EV-Project/Motor-interface/README.md

# Motor-interface

## Description
This motor-interface board is used to connect motor and motor controller.

## Requirements
Power: 96V Current: 400A
Connections: PC USB 
Safety: Fuse
Survivability: IP 6/7
Size: square or retangular
