EV-Project/Motor-interface/PNG/bottom.png

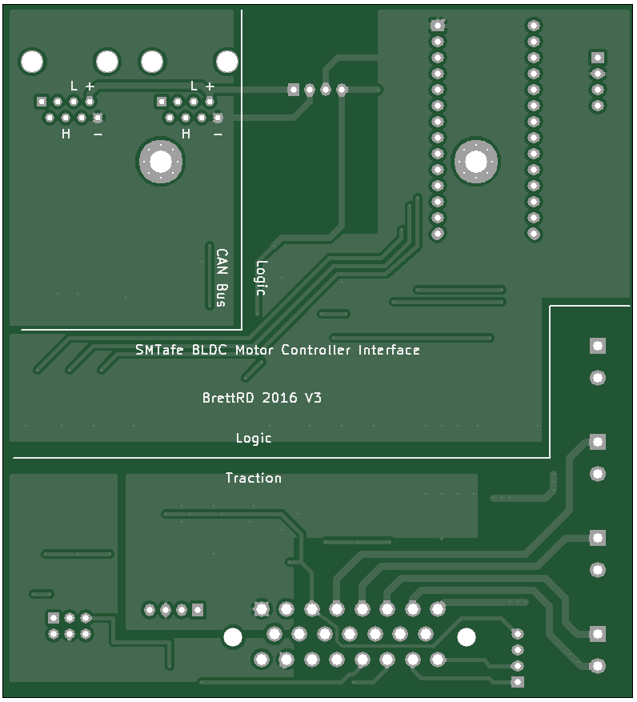
PNG/bottom.png
