EV-Project/Motor-interface/PNG/top.png

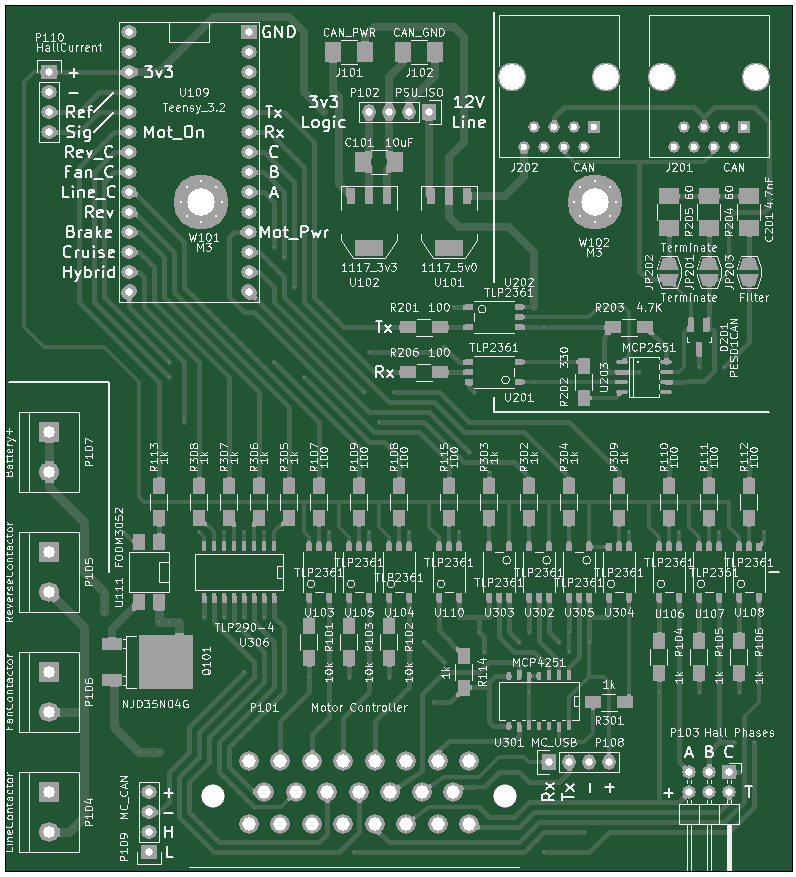
PNG/top.png
