EV-Project/Motor-interface/Motor-interface.kicad_pcb

## KiCad design Motor-interface.kicad_pcb (2016-11-17)

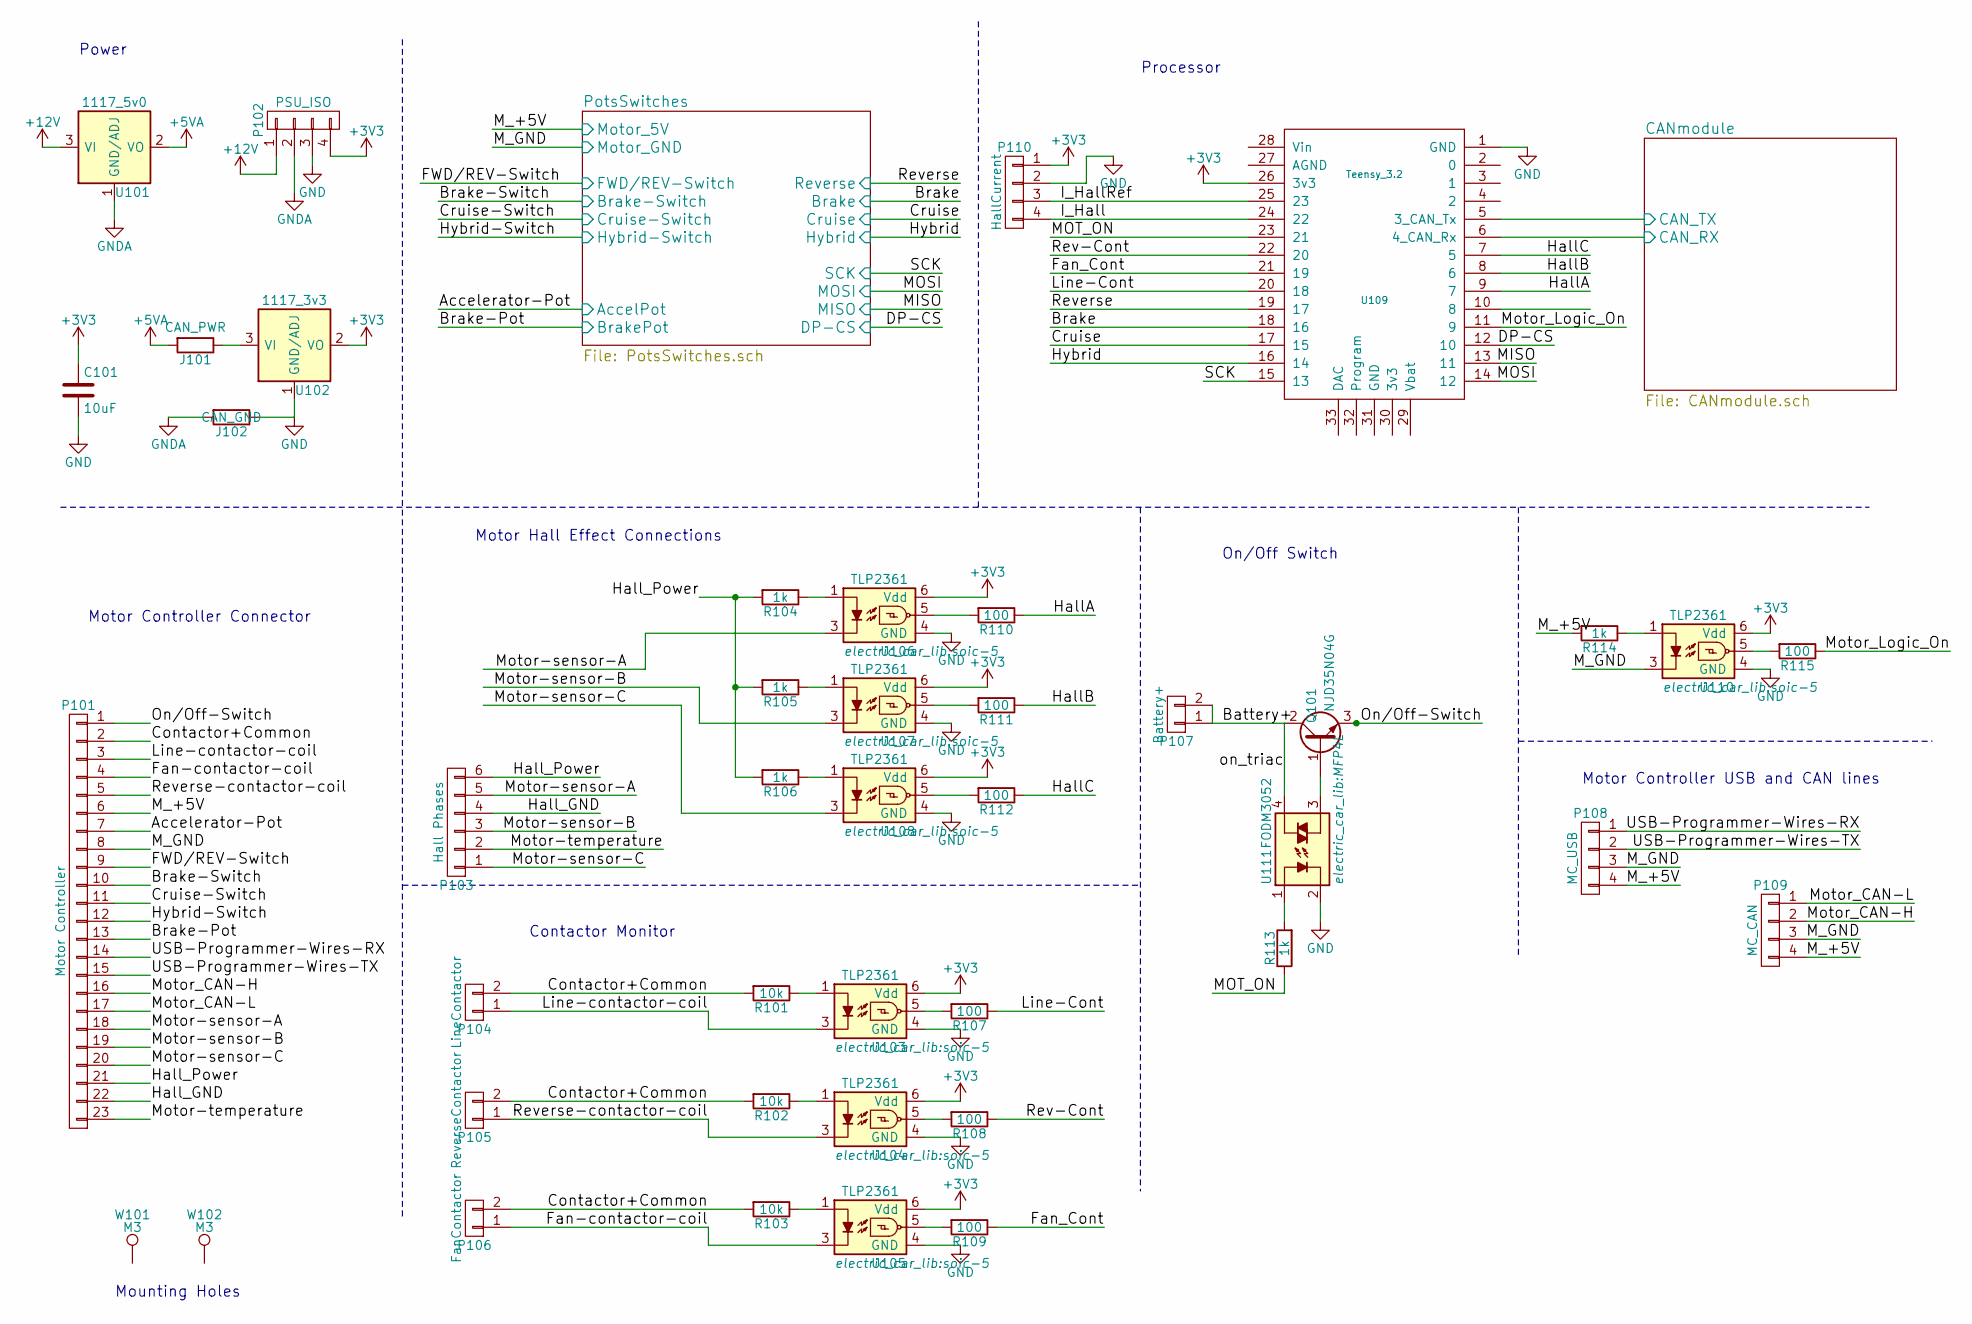
[picture p6: schematic Motor-interface.sch, Motor Interface]

Parts:
C101: 10uF; C_1210_HandSoldering
J101: CAN_PWR; R_1210_HandSoldering
J102: CAN_GND; R_1210_HandSoldering
P101: Motor Controller; TE_23_pins_776087-1_connector
P102: PSU_ISO; Pin_Header_Straight_1x04
P103: Hall Phases; Pin_Header_Angled_2x03
P104: LineContactor; bornier2
P105: ReverseContactor; bornier2
P106: FanContactor; bornier2
P107: Battery+; bornier2
P108: MC_USB; Pin_Header_Straight_1x04
P109: MC_CAN; Pin_Header_Straight_1x04
P110: HallCurrent; Pin_Header_Straight_1x04
Q101: NJD35N04G; SOT-428
R101, R102, R103: 10k; R_1206_HandSoldering
R104, R105, R106, R113, R114: 1k; R_1206_HandSoldering
R107, R108, R109, R110, R111, R112, R115: 100; R_1206_HandSoldering
U101: 1117_5v0; SOT-223
U102: 1117_3v3; SOT-223
U103, U104, U105, U106, U107, U108, U110: TLP2361; soic-5
U109: Teensy_3.2; Teensy3.2
U111: FODM3052; MFP4L
W101, W102: M3; MountingHole_3.5mm_Pad_Via

Connections:
+3V3: C101.1, P102.4, P110.1, U102.2 (VO), U103.6 (Vdd), U104.6 (Vdd), U105.6 (Vdd), U106.6 (Vdd), U107.6 (Vdd), U108.6 (Vdd), U109.26 (3v3), U110.6 (Vdd); also elsewhere on the board
+5VA: J101.2, U101.2 (VO); also elsewhere on the board
+12V: P102.1, U101.3 (VI); also elsewhere on the board
/Accelerator-Pot: P101.7; also elsewhere on the board
/Battery+: P107.1, P107.2, Q101.2 (C), U111.4
/Brake: U109.18 (16); also elsewhere on the board
/Brake-Pot: P101.13; also elsewhere on the board
/Brake-Switch: P101.10; also elsewhere on the board
/CANmodule/CAN_RX: U109.6 (4_CAN_Rx); also elsewhere on the board
/CANmodule/CAN_TX: U109.5 (3_CAN_Tx); also elsewhere on the board
/Contactor+Common: P101.2, P104.2, P105.2, P106.2, R101.2, R102.2, R103.2
/Cruise: U109.17 (15); also elsewhere on the board
/Cruise-Switch: P101.11; also elsewhere on the board
/DP-CS: U109.12 (10); also elsewhere on the board
/FWD/REV-Switch: P101.9; also elsewhere on the board
/Fan-contactor-coil: P101.4, P106.1, U105.3
/Fan_Cont: R109.1, U109.21 (19)
/HallA: R110.1, U109.9 (7)
/HallB: R111.1, U109.8 (6)
/HallC: R112.1, U109.7 (5)
/Hall_GND: P101.22, P103.4
/Hall_Power: P101.21, P103.6, R104.2, R105.2, R106.2
/Hybrid: U109.16 (14); also elsewhere on the board
/Hybrid-Switch: P101.12; also elsewhere on the board
/I_Hall: P110.4, U109.24 (22)
/I_HallRef: P110.3, U109.25 (23)
/Line-Cont: R107.1, U109.20 (18)
/Line-contactor-coil: P101.3, P104.1, U103.3
/MISO: U109.13 (11); also elsewhere on the board
/MOSI: U109.14 (12); also elsewhere on the board
/MOT_ON: R113.1, U109.23 (21)
/M_+5V: P101.6, P108.4, P109.4, R114.2; also elsewhere on the board
/M_GND: P101.8, P108.3, P109.3, U110.3; also elsewhere on the board
/Motor-sensor-A: P101.18, P103.5, U106.3
/Motor-sensor-B: P101.19, P103.3, U107.3
/Motor-sensor-C: P101.20, P103.1, U108.3
/Motor-temperature: P101.23, P103.2
/Motor_CAN-H: P101.16, P109.2
/Motor_CAN-L: P101.17, P109.1
/Motor_Logic_On: R115.1, U109.11 (9)
/On/Off-Switch: P101.1, Q101.3 (E)
/Rev-Cont: R108.1, U109.22 (20)
/Reverse: U109.19 (17); also elsewhere on the board
/Reverse-contactor-coil: P101.5, P105.1, U104.3
/SCK: U109.15 (13); also elsewhere on the board
/USB-Programmer-Wires-RX: P101.14, P108.1
/USB-Programmer-Wires-TX: P101.15, P108.2
GND: C101.2, J102.1, P102.3, P110.2, U102.1 (GND/ADJ), U103.4 (GND), U104.4 (GND), U105.4 (GND), U106.4 (GND), U107.4 (GND), U108.4 (GND), U109.1 (GND), U110.4 (GND), U111.2; also elsewhere on the board
GNDA: J102.2, P102.2, U101.1 (GND/ADJ); also elsewhere on the board
unnamed: J101.1, U102.3 (VI)
unnamed: Q101.1 (B), U111.3
unnamed: R101.1, U103.1
unnamed: R102.1, U104.1
unnamed: R103.1, U105.1
unnamed: R104.1, U106.1
unnamed: R105.1, U107.1
unnamed: R106.1, U108.1
unnamed: R107.2, U103.5
unnamed: R108.2, U104.5
unnamed: R109.2, U105.5
unnamed: R110.2, U106.5
unnamed: R111.2, U107.5
unnamed: R112.2, U108.5
unnamed: R113.2, U111.1
unnamed: R114.1, U110.1
unnamed: R115.2, U110.5

Notes on the sheet:
On/Off Switch
Contactor Monitor
Processor
Motor Hall Effect Connections
Motor Controller USB and CAN lines
Power
Motor Controller Connector
Mounting Holes

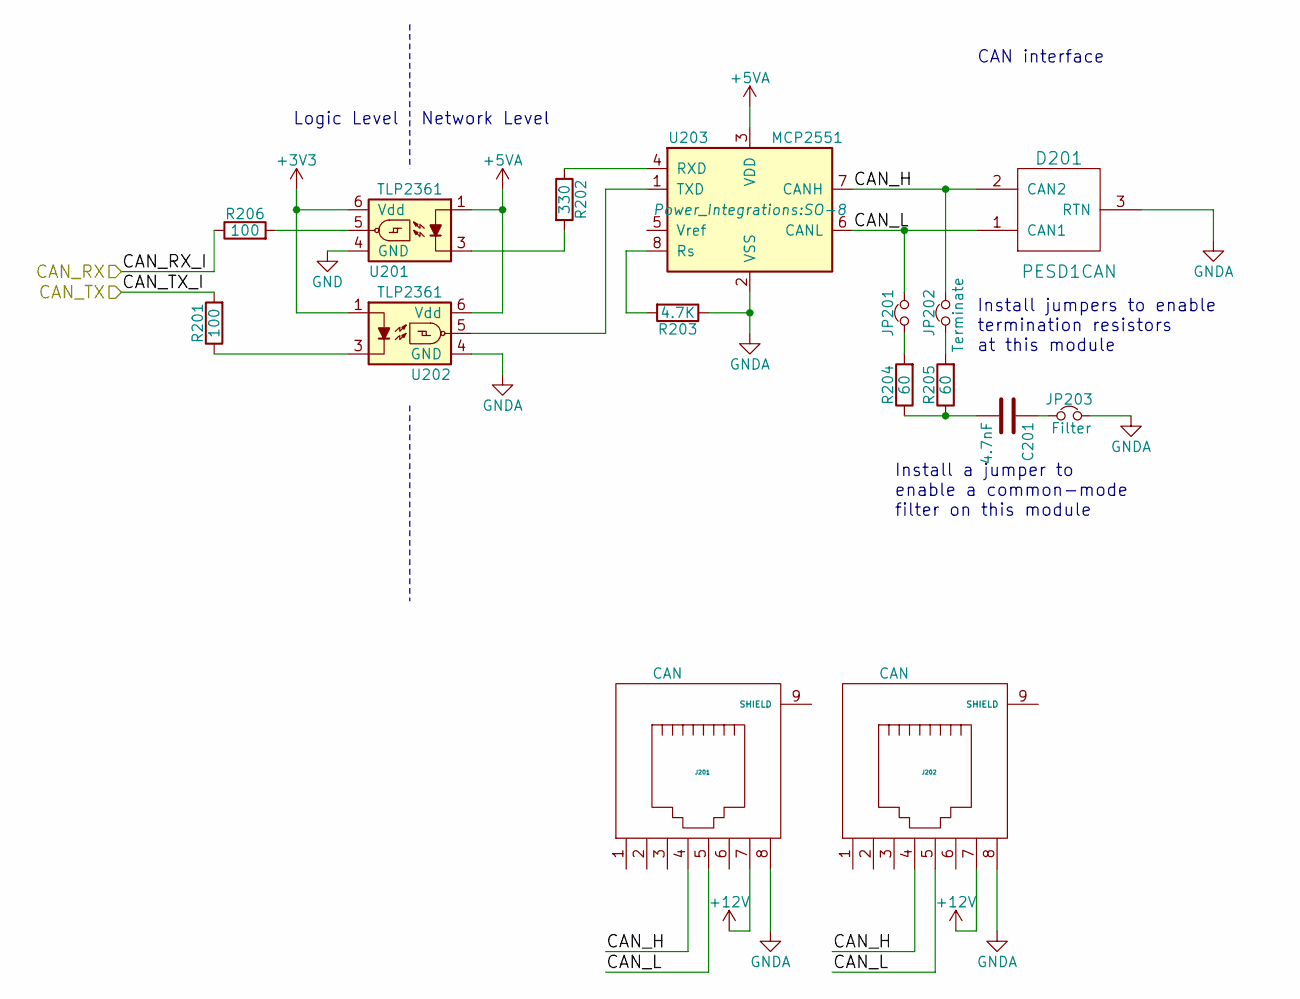
[picture p7: schematic CANmodule.sch, CAN adapter]

Parts:
C201: 4.7nF; C_1210_HandSoldering
D201: PESD1CAN; SOT-23_Handsoldering
J201, J202: CAN; RJ45_8
JP201, JP202: Terminate; JumperSingle
JP203: Filter; JumperSingle
R201, R206: 100; R_1206_HandSoldering
R202: 330; R_1206_HandSoldering
R203: 4.7K; R_1206_HandSoldering
R204, R205: 60; R_1210_HandSoldering
U201, U202: TLP2361; soic-5
U203: MCP2551; SO-8

Connections:
+3V3: U201.6 (Vdd), U202.1; also elsewhere on the board
+5VA: U201.1, U202.6 (Vdd), U203.3 (VDD); also elsewhere on the board
+12V: J201.7, J202.7; also elsewhere on the board
/CANmodule/CAN_H: D201.2 (CAN2), J201.4, J202.4, JP202.1, U203.7 (CANH)
/CANmodule/CAN_L: D201.1 (CAN1), J201.5, J202.5, JP201.2, U203.6 (CANL)
/CANmodule/CAN_RX: R206.1; also elsewhere on the board
/CANmodule/CAN_TX: R201.2; also elsewhere on the board
GND: U201.4 (GND); also elsewhere on the board
GNDA: D201.3 (RTN), J201.8, J202.8, JP203.2, R203.1, U202.4 (GND), U203.2 (VSS); also elsewhere on the board
unnamed: C201.1, JP203.1
unnamed: C201.2, R204.1, R205.1
unnamed: JP201.1, R204.2
unnamed: JP202.2, R205.2
unnamed: R201.1, U202.3
unnamed: R202.1, U203.4 (RXD)
unnamed: R202.2, U201.3
unnamed: R203.2, U203.8 (Rs)
unnamed: R206.2, U201.5
unnamed: U202.5, U203.1 (TXD)

Notes on the sheet:
Logic Level
Network Level
Install jumpers to enable termination resistors at this module
Install a jumper to enable a common-mode filter on this module
CAN interface

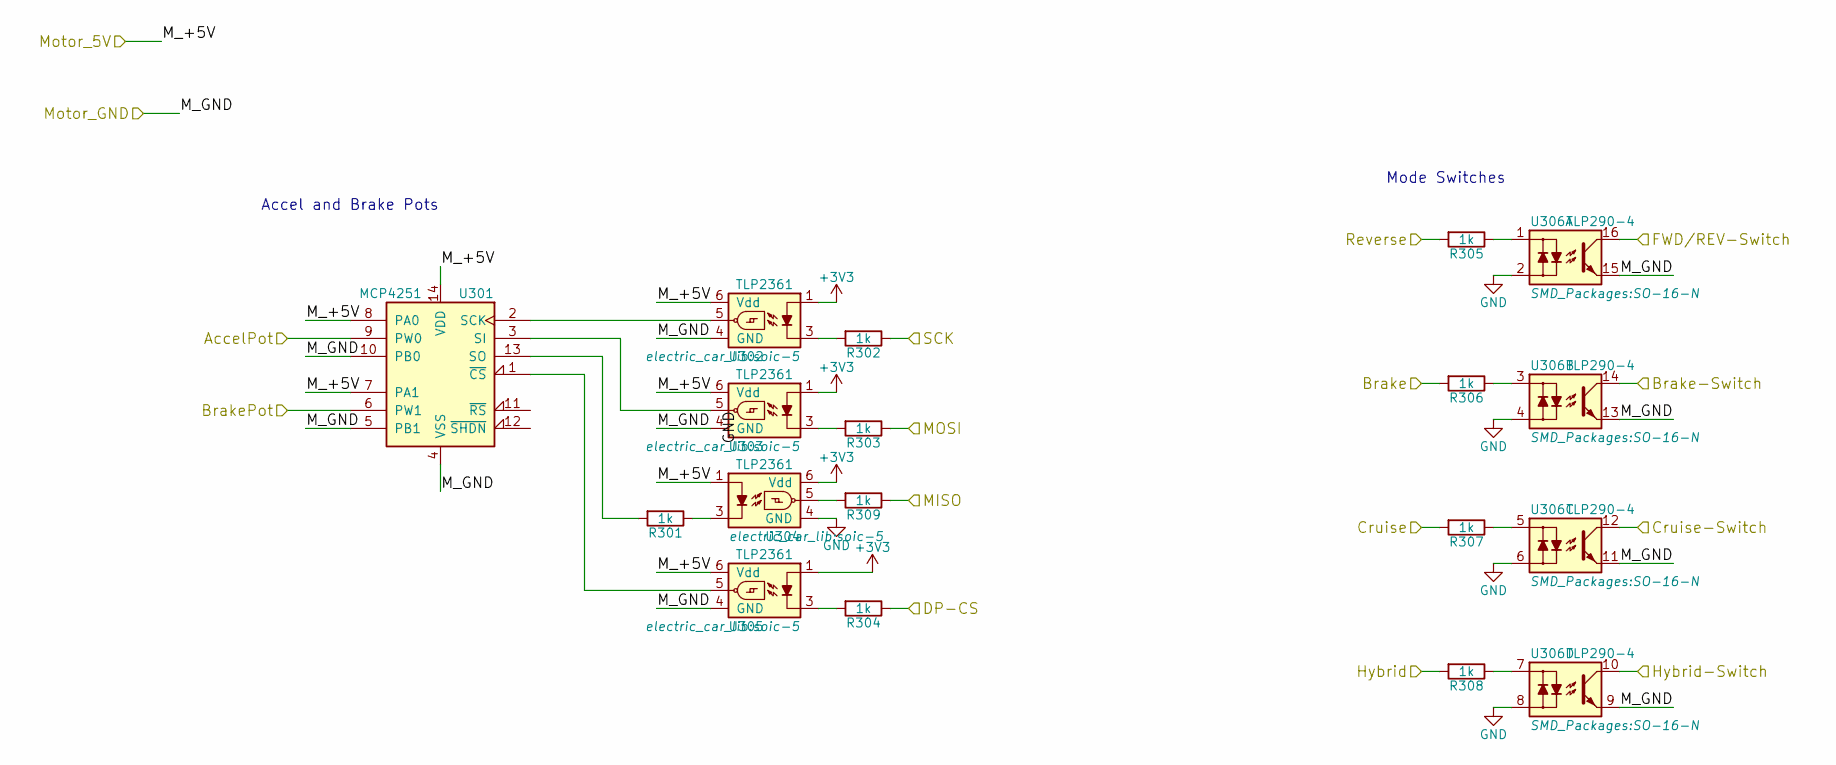
[picture p8: schematic PotsSwitches.sch, Motor Interface]

Parts:
R301, R302, R303, R304, R305, R306, R307, R308, R309: 1k; R_1206_HandSoldering
U301: MCP4251; SOIC-14_N
U302, U303, U304, U305: TLP2361; soic-5
U306: TLP290-4; SO-16-N

Connections:
+3V3: U302.1, U303.1, U304.6 (Vdd), U305.1; also elsewhere on the board
/Accelerator-Pot: U301.9 (PW0); also elsewhere on the board
/Brake: R306.2; also elsewhere on the board
/Brake-Pot: U301.6 (PW1); also elsewhere on the board
/Brake-Switch: U306.14; also elsewhere on the board
/Cruise: R307.2; also elsewhere on the board
/Cruise-Switch: U306.12; also elsewhere on the board
/DP-CS: R304.1; also elsewhere on the board
/FWD/REV-Switch: U306.16; also elsewhere on the board
/Hybrid: R308.2; also elsewhere on the board
/Hybrid-Switch: U306.10; also elsewhere on the board
/MISO: R309.1; also elsewhere on the board
/MOSI: R303.1; also elsewhere on the board
/M_+5V: U301.7 (PA1), U301.8 (PA0), U301.14 (VDD), U302.6 (Vdd), U303.6 (Vdd), U304.1, U305.6 (Vdd); also elsewhere on the board
/M_GND: U301.4 (VSS), U301.5 (PB1), U301.10 (PB0), U302.4 (GND), U303.4 (GND), U305.4 (GND), U306.9, U306.11, U306.13, U306.15; also elsewhere on the board
/Reverse: R305.2; also elsewhere on the board
/SCK: R302.1; also elsewhere on the board
GND: U304.4 (GND), U306.2, U306.4, U306.6, U306.8; also elsewhere on the board
unnamed: R301.1, U304.3
unnamed: R301.2, U301.13 (SO)
unnamed: R302.2, U302.3
unnamed: R303.2, U303.3
unnamed: R304.2, U305.3
unnamed: R305.1, U306.1
unnamed: R306.1, U306.3
unnamed: R307.1, U306.5
unnamed: R308.1, U306.7
unnamed: R309.2, U304.5
unnamed: U301.1 (~CS), U305.5
unnamed: U301.2 (SCK), U302.5
unnamed: U301.3 (SI), U303.5

Notes on the sheet:
Accel and Brake Pots
Mode Switches

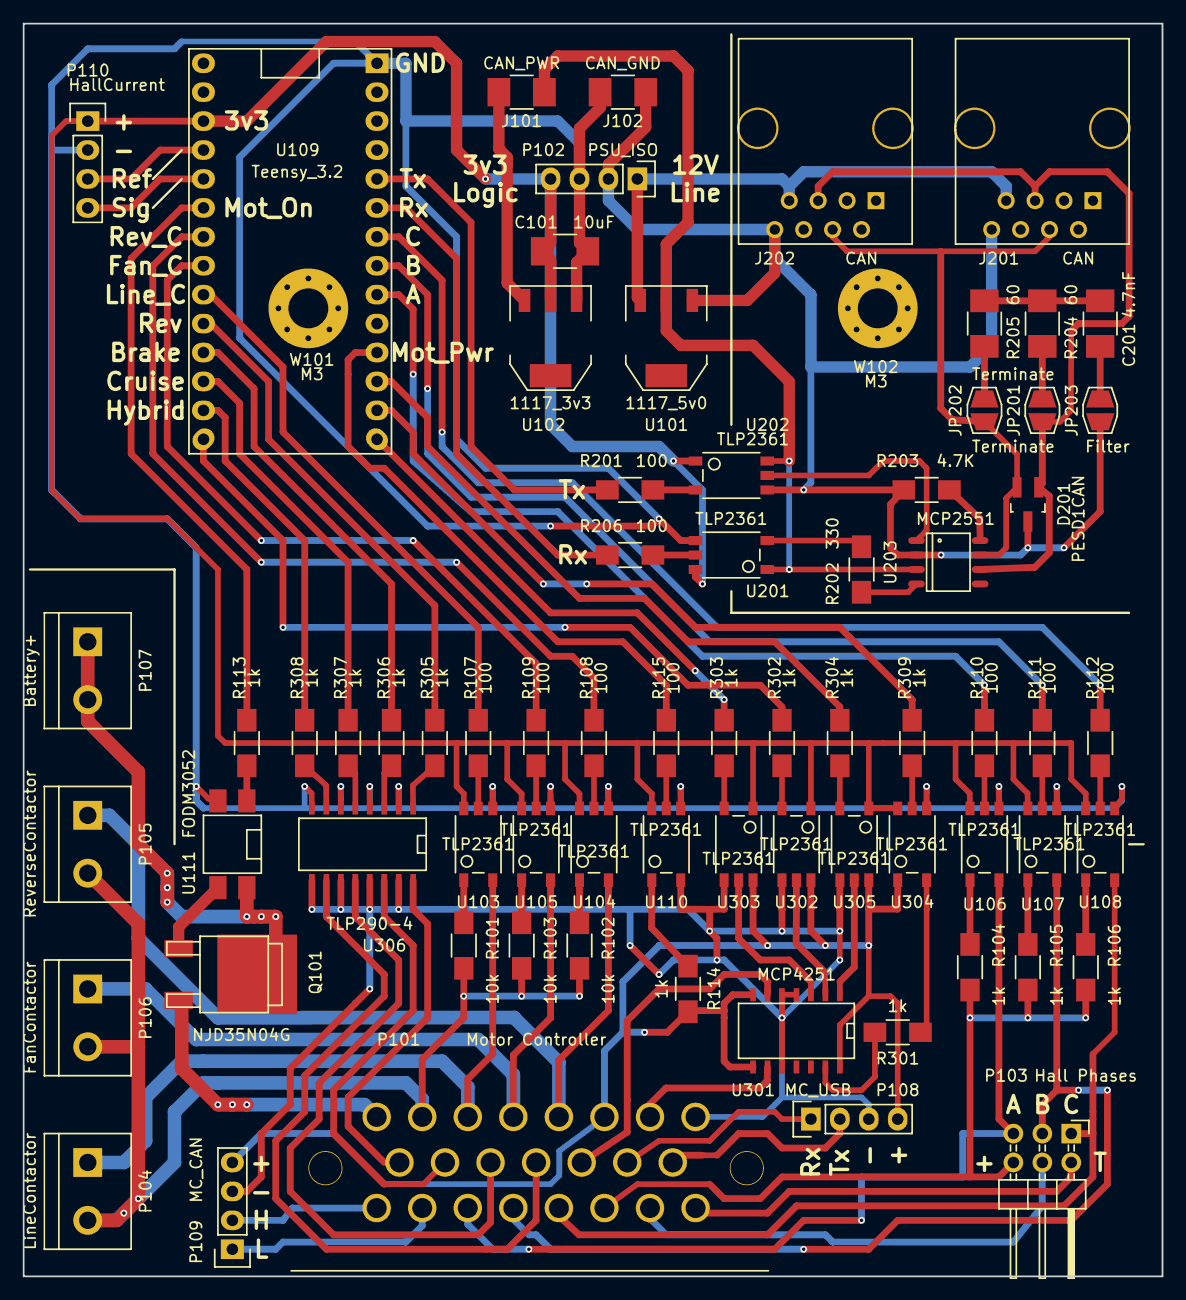
[picture p9: board Motor-interface.kicad_pcb from above]

Board: 2 copper layers, 100.0 x 110.0 mm, 73 parts (0 on the bottom side), 91 nets.
