EV-Project/Motor-interface/(threads)

Thread 1 (2016-12-05):

PSU Footprint Fix

atrophy, 2016-12-05:
Replace PSU with correct footprint for NCS1S2403SC.
Datasheet with drawings: http://power.murata.com/data/power/ncl/kdc_ncs1.pdf

Thread 3 (2016-12-05):

Secondary CAN Bus

atrophy, 2016-12-05:
Add second on-board CAN network for Motor Controller CAN to MCU (Board local bus only). Isolation critical!

Thread 4 (2016-12-05):

Hall Sensor Connector

atrophy, 2016-12-05:
Hall sensor connector is not appropriate, replace with more suitable connector.

Thread 5 (2016-12-05):

Diode bridge on BJT/Triac

atrophy, 2016-12-05:
Add a diode bridge to protect power control circuit.

atrophy, 2016-12-05:
Replaced by #7

Closed 2016-12-05.

Thread 6 (2016-12-05):

Status LEDs

atrophy, 2016-12-05:
Add status LEDs for:

- Board Logic Power
- Motor Controller Power Status
- FWD/Reverse/Brake (RGB?)
- Line Contactor Status
- Fan Contactor Status
- Reverse Contactor Status

Thread 7 (2016-12-05):

Replace Triac / BJT

atrophy, 2016-12-05:
Replace frequently failing Optotriac/BJT with 4N35 + Electromechanical Relay for reliability. Replaces #5
