EV-Project/Motor-interface/(commit log)

2016-10-11 created a generic CAN module
    [CANmodule.sch, Motor-interface.kicad_pcb, Motor-interface.sch]
2016-10-11 added digital pot
    [CANmodule.sch, Motor-interface.sch]
2016-10-18 edited wiring
    [Motor-interface.sch]
2016-10-25 Added TE 23pins and netlist
    [CANmodule.sch, Motor-interface.kicad_pcb, Motor-interface.sch]
2016-11-01 mode switches and coil contactors
    [CANmodule.sch, Motor-interface.sch]
2016-11-08 added hall effect connector and USB and CAN lines
    [CANmodule.sch, Motor-interface.sch]
2016-11-15 added hall-uC resistors for speed monitoring
    [CANmodule.sch, Motor-interface.sch]
2016-11-15 Isolated the Motor Controller, added PSU
    [CANmodule.sch, Motor-interface.sch, PotsSwitches.sch]
2016-11-15 most associations, started pcb
    [CANmodule.sch, Motor-interface.kicad_pcb, Motor-interface.sch, PotsSwitches.sch]
2016-11-15 removed files from other repo
    [Motor-interface.kicad_pcb, motor vehicle.kicad_pcb, motor vehicle.sch]
2016-11-15 PBC layout
    [Motor-interface.kicad_pcb, Motor-interface.sch]
2016-11-16 changed optos, removed relay, needs ssr
    [Motor-interface.sch, PotsSwitches.sch]
2016-11-16 minor tweaks, started layout
    [CANmodule.sch, Motor-interface.kicad_pcb, Motor-interface.sch, PotsSwitches.sch]
2016-11-16 swapped pins, arranged parts
    [Motor-interface.kicad_pcb, Motor-interface.sch, PotsSwitches.sch]
2016-11-16 laid out CAN hardware
    [Motor-interface.kicad_pcb, _saved_Motor-interface.sch]
2016-11-16 laid out halls and pots
    [Motor-interface.kicad_pcb, Motor-interface.sch, PotsSwitches.sch, _saved_Motor-interface.sch]
2016-11-16 laid out Contactors and monitors
    [CANmodule.sch, Motor-interface.kicad_pcb, Motor-interface.sch, PotsSwitches.sch]
2016-11-16 fixed triac, passed DRC
    [Motor-interface.kicad_pcb, Motor-interface.sch]
2016-11-16 renamed transistor
    [Motor-interface.kicad_pcb]
2016-11-16 renamed transistor (fixed)
    [Motor-interface.sch]
2016-11-17 silkscreen changes
    [Motor-interface.kicad_pcb]
2016-11-17 pour and silk edits
    [CANmodule.sch, Motor-interface.kicad_pcb, Motor-interface.sch]
2016-11-17 plotted gerbers
    [CANmodule.sch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]
2016-11-17 adjusted gerbers, exported pngs from gerblook.org
    [Motor-interface-B.Cu.gbr, Motor-interface-B.Mask.gbr, Motor-interface-B.SilkS.gbr, Motor-interface-Edge.Cuts.gbr, Motor-interface-F.Cu.gbr, Motor-interface-F.Mask.gbr, Motor-interface-F.SilkS.gbr, Motor-interface-NPTH.drl]
2016-11-17 renamed production files
    [Motor-interfaceV1-B.Cu.gbr, Motor-interfaceV1-B.Mask.gbr, Motor-interfaceV1-B.SilkS.gbr, Motor-interfaceV1-Edge.Cuts.gbr, Motor-interfaceV1-F.Cu.gbr, Motor-interfaceV1-F.Mask.gbr, Motor-interfaceV1-F.SilkS.gbr, Motor-interfaceV1-NPTH.drl]
2016-11-17 adjusted via sized
    [Motor-interface.kicad_pcb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]
2016-11-17 changed file extensions
    [Motor-interface.kicad_pcb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]
2016-11-30 added schematic PDFs
